computerguy096/Eagle-8/kicad/bom/eagle-8.csv

Reference | Value | Datasheet | Footprint | Qty | DNP | LCSC
C1,C2,C3,C4,C5,C6,C7,C8,C9,C10,C11,C12,C13,C14,C15,C16,C17,C18,C19,C20,C21,C22,C23,C24,C25,C26,C27,C28,C29,C38 | 100nF |  | Capacitor_SMD:C_0805_2012Metric | 30 |  | C1711
C30,C31,C32,C33,C34,C35,C36,C37 | 47uF |  | Capacitor_Tantalum_SMD:CP_EIA-7343-40_Kemet-Y_HandSolder | 8 |  | C600546
R1,R2,R3 | 150R |  | Resistor_SMD:R_0805_2012Metric | 3 |  | C17471
R4,R5,R6 | 10K |  | Resistor_SMD:R_0805_2012Metric | 3 |  | C17414
R7 | 0R |  | Resistor_SMD:R_0805_2012Metric | 1 |  | C17477
R14 | 68R |  | Resistor_SMD:R_0805_2012Metric | 1 |  | C17802
RN1,RN2,RN3,RN4,RN5,RN6,RN7,RN8,RN9,RN10,RN11,RN12,RN13,RN14,RN15,RN16,RN17,RN18,RN19,RN20,RN21,RN22,RN23,RN24,RN25,RN26,RN27,RN28,RN29,RN30,RN31,RN32,RN33,RN34,RN35 | 68R |  | eagle-8:VTT array | 35 |  | C429297
