computerguy096/Eagle-8/spacer.stl

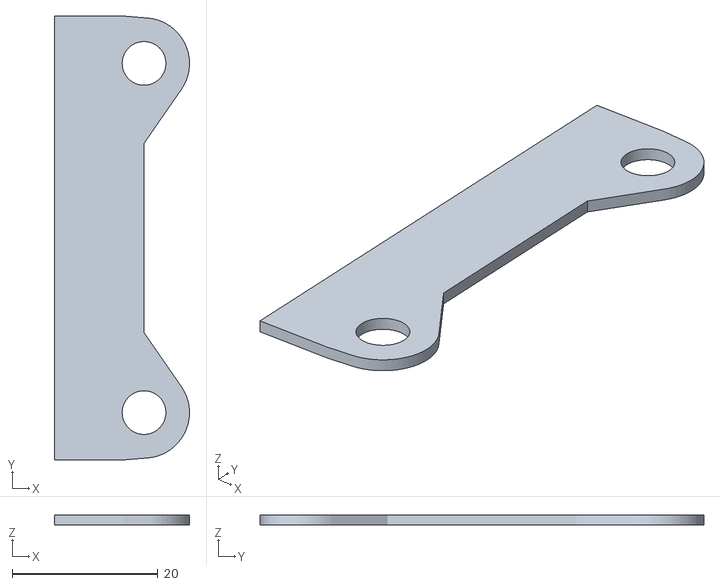
[picture p2: CAD file, 2026-10-31]
spacer.stl
18.5 x 61.0 x 1.40
