computerguy096/Eagle-8/kicad/eagle-8.kicad_pcb

## KiCad design kicad/eagle-8.kicad_pcb (2026-11-05)

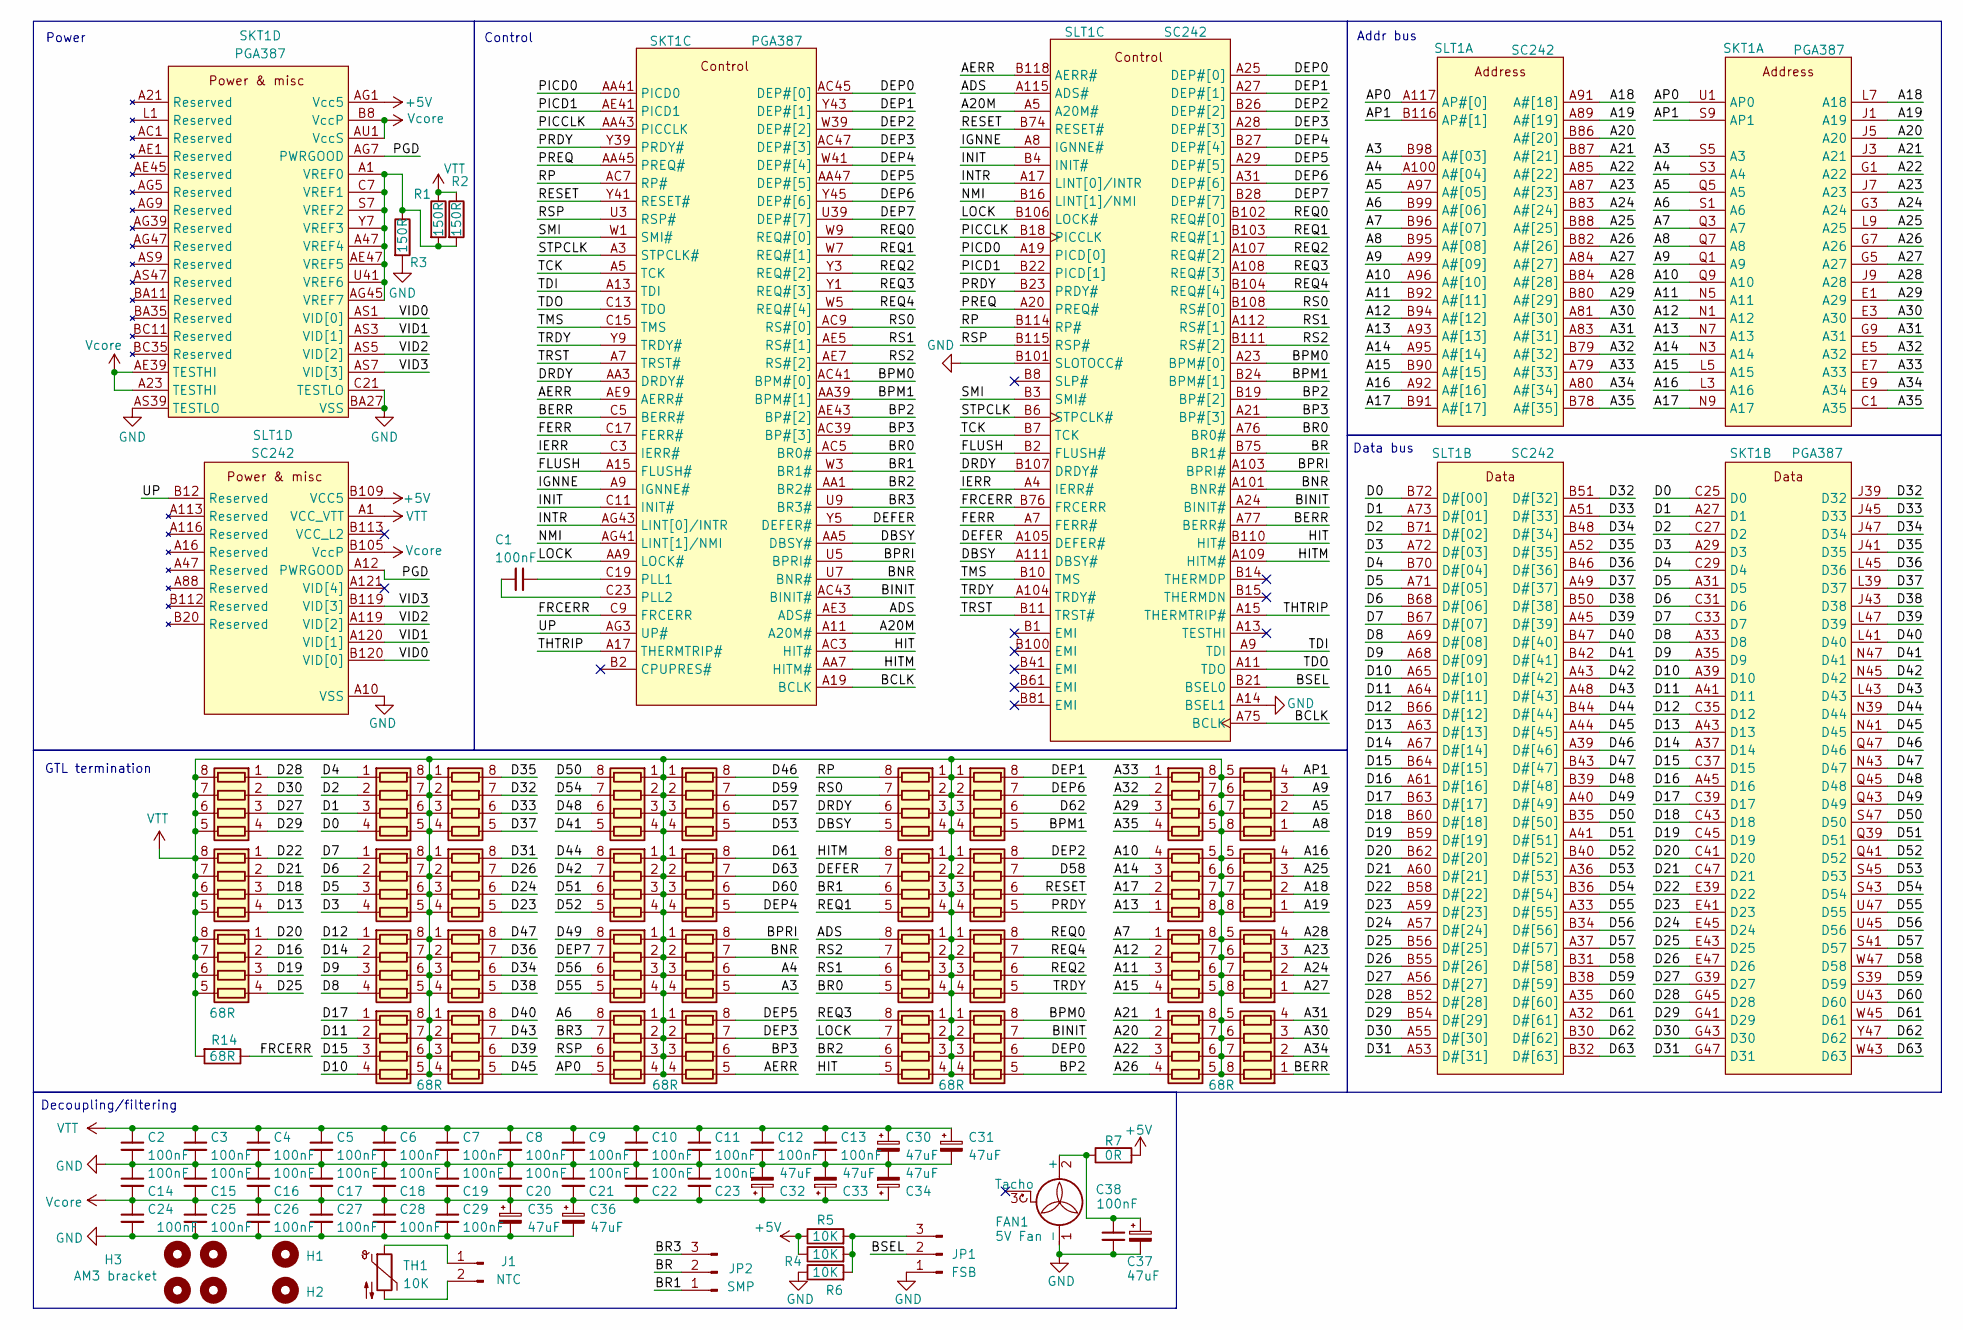
[picture p3: schematic eagle-8.kicad_sch]

Parts:
C1, C2: 100nF; C_0805_2012Metric; LCSC C1711
C3, C4, C5, C6, C7, C8, C9, C10, C11, C12, C13, C14, C15, C16, C17, C18, C19, C20, C21, C22, C23, C24, C25, C26, C27, C28, C29, C38: 100nF; C_0805_2012Metric
C30, C31, C32, C33, C34, C35, C37: 47uF; CP_EIA-7343-40_Kemet-Y_HandSolder
C36: 47uF; CP_EIA-7343-40_Kemet-Y_HandSolder; LCSC C600546
FAN1: 5V Fan; FanPinHeader_1x03_P2.54mm_Vertical
H1, H2: MountingHole; MountingHole_3.2mm_M3_DIN965
H3: AM3 bracket
J1: NTC; PinHeader_1x02_P2.54mm_Vertical
JP1: FSB; PinHeader_1x03_P2.54mm_Vertical
JP2: SMP; PinHeader_1x03_P2.54mm_Vertical
R1, R2, R3: 150R; R_0805_2012Metric; LCSC C17471
R4, R5, R6: 10K; R_0805_2012Metric; LCSC C17414
R7: 0R; R_0805_2012Metric; LCSC C17477
R14: 68R; R_0805_2012Metric; LCSC C17802
RN1, RN2, RN3, RN4, RN5, RN6, RN7, RN8, RN9, RN10, RN11, RN13, RN14, RN15, RN16, RN17, RN18, RN19, RN20, RN21, RN22, RN23, RN24, RN25, RN26, RN27, RN28, RN29, RN30, RN31, RN32, RN33, RN34, RN35: 68R; VTT array
RN12: 68R; VTT array; LCSC C429297
SKT1: PGA387
SLT1: SC242; Slot 1
TH1: 10K; PinHeader_1x02_P2.54mm_Vertical

Connections:
+5V: R4.1, R5.1, R7.2, SKT1.AG1 (Vcc5), SLT1.B109 (VCC5)
/A3: RN31.5 (R4.2), SKT1.S5 (A3), SLT1.B98 (A#[03])
/A4: RN31.6 (R3.2), SKT1.S3 (A4), SLT1.A100 (A#[04])
/A5: RN1.2 (R2.1), SKT1.Q5 (A5), SLT1.A97 (A#[05])
/A6: RN35.8 (R1.2), SKT1.S1 (A6), SLT1.B99 (A#[06])
/A7: RN4.1 (R1.1), SKT1.Q3 (A7), SLT1.B96 (A#[07])
/A8: RN1.1 (R1.1), SKT1.Q7 (A8), SLT1.B95 (A#[08])
/A9: RN1.3 (R3.1), SKT1.Q1 (A9), SLT1.A99 (A#[09])
/A10: RN2.4 (R4.1), SKT1.Q9 (A10), SLT1.A96 (A#[10])
/A11: RN4.3 (R3.1), SKT1.N5 (A11), SLT1.B92 (A#[11])
/A12: RN4.2 (R2.1), SKT1.N1 (A12), SLT1.B94 (A#[12])
/A13: RN2.1 (R1.1), SKT1.N7 (A13), SLT1.A93 (A#[13])
/A14: RN2.3 (R3.1), SKT1.N3 (A14), SLT1.A95 (A#[14])
/A15: RN4.4 (R4.1), SKT1.L5 (A15), SLT1.B90 (A#[15])
/A16: RN3.4 (R4.1), SKT1.L3 (A16), SLT1.A92 (A#[16])
/A17: RN2.2 (R2.1), SKT1.N9 (A17), SLT1.B91 (A#[17])
/A18: RN3.2 (R2.1), SKT1.L7 (A18), SLT1.A91 (A#[18])
/A19: RN3.1 (R1.1), SKT1.J1 (A19), SLT1.A89 (A#[19])
/A20: RN6.2 (R2.1), SKT1.J5 (A20), SLT1.B86 (A#[20])
/A20M: SKT1.A11 (A20M#), SLT1.A5 (A20M#)
/A21: RN6.1 (R1.1), SKT1.J3 (A21), SLT1.B87 (A#[21])
/A22: RN6.3 (R3.1), SKT1.G1 (A22), SLT1.A85 (A#[22])
/A23: RN5.3 (R3.1), SKT1.J7 (A23), SLT1.A87 (A#[23])
/A24: RN5.2 (R2.1), SKT1.G3 (A24), SLT1.B83 (A#[24])
/A25: RN3.3 (R3.1), SKT1.L9 (A25), SLT1.B88 (A#[25])
/A26: RN6.4 (R4.1), SKT1.G7 (A26), SLT1.B82 (A#[26])
/A27: RN5.1 (R1.1), SKT1.G5 (A27), SLT1.A84 (A#[27])
/A28: RN5.4 (R4.1), SKT1.J9 (A28), SLT1.B84 (A#[28])
/A29: RN24.3 (R3.1), SKT1.E1 (A29), SLT1.B80 (A#[29])
/A30: RN7.3 (R3.1), SKT1.E3 (A30), SLT1.A81 (A#[30])
/A31: RN7.4 (R4.1), SKT1.G9 (A31), SLT1.A83 (A#[31])
/A32: RN24.2 (R2.1), SKT1.E5 (A32), SLT1.B79 (A#[32])
/A33: RN24.1 (R1.1), SKT1.E7 (A33), SLT1.A79 (A#[33])
/A34: RN7.2 (R2.1), SKT1.E9 (A34), SLT1.A80 (A#[34])
/A35: RN24.4 (R4.1), SKT1.C1 (A35), SLT1.B78 (A#[35])
/ADS: RN29.8 (R1.2), SKT1.AE3 (ADS#), SLT1.A115 (ADS#)
/AERR: RN32.5 (R4.2), SKT1.AE9 (AERR#), SLT1.B118 (AERR#)
/AP0: RN35.5 (R4.2), SKT1.U1 (AP0), SLT1.A117 (AP#[0])
/AP1: RN1.4 (R4.1), SKT1.S9 (AP1), SLT1.B116 (AP#[1])
/BCLK: SKT1.A19 (BCLK), SLT1.A75 (BCLK)
/BERR: RN7.1 (R1.1), SKT1.C5 (BERR#), SLT1.A77 (BERR#)
/BINIT: RN28.7 (R2.2), SKT1.AC43 (BINIT#), SLT1.A24 (BINIT#)
/BNR: RN31.7 (R2.2), SKT1.U7 (BNR#), SLT1.A101 (BNR#)
/BP2: RN28.5 (R4.2), SKT1.AE43 (BP#[2]), SLT1.B19 (BP#[2])
/BP3: RN32.6 (R3.2), SKT1.AC39 (BP#[3]), SLT1.A21 (BP#[3])
/BPM0: RN28.8 (R1.2), SKT1.AC41 (BPM#[0]), SLT1.A23 (BPM#[0])
/BPM1: RN25.5 (R4.2), SKT1.AA39 (BPM#[1]), SLT1.B24 (BPM#[1])
/BPRI: RN31.8 (R1.2), SKT1.U5 (BPRI#), SLT1.A103 (BPRI#)
/BR: JP2.2, SLT1.B75 (BR1#)
/BR0: RN29.5 (R4.2), SKT1.AC5 (BR0#), SLT1.A76 (BR0#)
/BR1: JP2.1, RN34.6 (R3.2), SKT1.W3 (BR1#)
/BR2: RN30.6 (R3.2), SKT1.AA1 (BR2#)
/BR3: JP2.3, RN35.7 (R2.2), SKT1.U9 (BR3#)
/BSEL: JP1.2, SLT1.B21 (BSEL0)
/D0: RN8.4 (R4.1), SKT1.C25 (D0), SLT1.B72 (D#[00])
/D1: RN8.3 (R3.1), SKT1.A27 (D1), SLT1.A73 (D#[01])
/D2: RN8.2 (R2.1), SKT1.C27 (D2), SLT1.B71 (D#[02])
/D3: RN9.4 (R4.1), SKT1.A29 (D3), SLT1.A72 (D#[03])
/D4: RN8.1 (R1.1), SKT1.C29 (D4), SLT1.B70 (D#[04])
/D5: RN9.3 (R3.1), SKT1.A31 (D5), SLT1.A71 (D#[05])
/D6: RN9.2 (R2.1), SKT1.C31 (D6), SLT1.B68 (D#[06])
/D7: RN9.1 (R1.1), SKT1.C33 (D7), SLT1.B67 (D#[07])
/D8: RN10.4 (R4.1), SKT1.A33 (D8), SLT1.A69 (D#[08])
/D9: RN10.3 (R3.1), SKT1.A35 (D9), SLT1.A68 (D#[09])
/D10: RN11.4 (R4.1), SKT1.A39 (D10), SLT1.A65 (D#[10])
/D11: RN11.2 (R2.1), SKT1.A41 (D11), SLT1.A64 (D#[11])
/D12: RN10.1 (R1.1), SKT1.C35 (D12), SLT1.B66 (D#[12])
/D13: RN13.4 (R4.1), SKT1.A43 (D13), SLT1.A63 (D#[13])
/D14: RN10.2 (R2.1), SKT1.A37 (D14), SLT1.A67 (D#[14])
/D15: RN11.3 (R3.1), SKT1.C37 (D15), SLT1.B64 (D#[15])
/D16: RN14.2 (R2.1), SKT1.A45 (D16), SLT1.A61 (D#[16])
/D17: RN11.1 (R1.1), SKT1.C39 (D17), SLT1.B63 (D#[17])
/D18: RN13.3 (R3.1), SKT1.C43 (D18), SLT1.B60 (D#[18])
/D19: RN14.3 (R3.1), SKT1.C45 (D19), SLT1.B59 (D#[19])
/D20: RN14.1 (R1.1), SKT1.C41 (D20), SLT1.B62 (D#[20])
/D21: RN13.2 (R2.1), SKT1.C47 (D21), SLT1.A60 (D#[21])
/D22: RN13.1 (R1.1), SKT1.E39 (D22), SLT1.B58 (D#[22])
/D23: RN16.5 (R4.2), SKT1.E41 (D23), SLT1.A59 (D#[23])
/D24: RN16.6 (R3.2), SKT1.E45 (D24), SLT1.A57 (D#[24])
/D25: RN14.4 (R4.1), SKT1.E43 (D25), SLT1.B56 (D#[25])
/D26: RN16.7 (R2.2), SKT1.E47 (D26), SLT1.B55 (D#[26])
/D27: RN12.3 (R3.1), SKT1.G39 (D27), SLT1.A56 (D#[27])
/D28: RN12.1 (R1.1), SKT1.G45 (D28), SLT1.B52 (D#[28])
/D29: RN12.4 (R4.1), SKT1.G41 (D29), SLT1.B54 (D#[29])
/D30: RN12.2 (R2.1), SKT1.G43 (D30), SLT1.A55 (D#[30])
/D31: RN16.8 (R1.2), SKT1.G47 (D31), SLT1.A53 (D#[31])
/D32: RN15.7 (R2.2), SKT1.J39 (D32), SLT1.B51 (D#[32])
/D33: RN15.6 (R3.2), SKT1.J45 (D33), SLT1.A51 (D#[33])
/D34: RN17.6 (R3.2), SKT1.J47 (D34), SLT1.B48 (D#[34])
/D35: RN15.8 (R1.2), SKT1.J41 (D35), SLT1.A52 (D#[35])
/D36: RN17.7 (R2.2), SKT1.L45 (D36), SLT1.B46 (D#[36])
/D37: RN15.5 (R4.2), SKT1.L39 (D37), SLT1.A49 (D#[37])
/D38: RN17.5 (R4.2), SKT1.J43 (D38), SLT1.B50 (D#[38])
/D39: RN18.6 (R3.2), SKT1.L47 (D39), SLT1.A45 (D#[39])
/D40: RN18.8 (R1.2), SKT1.L41 (D40), SLT1.B47 (D#[40])
/D41: RN19.5 (R4.2), SKT1.N47 (D41), SLT1.B42 (D#[41])
/D42: RN20.7 (R2.2), SKT1.N45 (D42), SLT1.A43 (D#[42])
/D43: RN18.7 (R2.2), SKT1.L43 (D43), SLT1.A48 (D#[43])
/D44: RN20.8 (R1.2), SKT1.N39 (D44), SLT1.B44 (D#[44])
/D45: RN18.5 (R4.2), SKT1.N41 (D45), SLT1.A44 (D#[45])
/D46: RN22.8 (R1.2), SKT1.Q47 (D46), SLT1.A39 (D#[46])
/D47: RN17.8 (R1.2), SKT1.N43 (D47), SLT1.B43 (D#[47])
/D48: RN19.6 (R3.2), SKT1.Q45 (D48), SLT1.B39 (D#[48])
/D49: RN21.8 (R1.2), SKT1.Q43 (D49), SLT1.A40 (D#[49])
/D50: RN19.8 (R1.2), SKT1.S47 (D50), SLT1.B35 (D#[50])
/D51: RN20.6 (R3.2), SKT1.Q39 (D51), SLT1.A41 (D#[51])
/D52: RN20.5 (R4.2), SKT1.Q41 (D52), SLT1.B40 (D#[52])
/D53: RN22.5 (R4.2), SKT1.S45 (D53), SLT1.A36 (D#[53])
/D54: RN19.7 (R2.2), SKT1.S43 (D54), SLT1.B36 (D#[54])
/D55: RN21.5 (R4.2), SKT1.U47 (D55), SLT1.A33 (D#[55])
/D56: RN21.6 (R3.2), SKT1.U45 (D56), SLT1.B34 (D#[56])
/D57: RN22.6 (R3.2), SKT1.S41 (D57), SLT1.A37 (D#[57])
/D58: RN26.7 (R2.2), SKT1.W47 (D58), SLT1.B31 (D#[58])
/D59: RN22.7 (R2.2), SKT1.S39 (D59), SLT1.B38 (D#[59])
/D60: RN23.6 (R3.2), SKT1.U43 (D60), SLT1.A35 (D#[60])
/D61: RN23.8 (R1.2), SKT1.W45 (D61), SLT1.A32 (D#[61])
/D62: RN25.6 (R3.2), SKT1.Y47 (D62), SLT1.B30 (D#[62])
/D63: RN23.7 (R2.2), SKT1.W43 (D63), SLT1.B32 (D#[63])
/DBSY: RN33.5 (R4.2), SKT1.AA5 (DBSY#), SLT1.A111 (DBSY#)
/DEFER: RN34.7 (R2.2), SKT1.Y5 (DEFER#), SLT1.A105 (DEFER#)
/DEP0: RN28.6 (R3.2), SKT1.AC45 (DEP#[0]), SLT1.A25 (DEP#[0])
/DEP1: RN25.8 (R1.2), SKT1.Y43 (DEP#[1]), SLT1.A27 (DEP#[1])
/DEP2: RN26.8 (R1.2), SKT1.W39 (DEP#[2]), SLT1.B26 (DEP#[2])
/DEP3: RN32.7 (R2.2), SKT1.AC47 (DEP#[3]), SLT1.A28 (DEP#[3])
/DEP4: RN23.5 (R4.2), SKT1.W41 (DEP#[4]), SLT1.B27 (DEP#[4])
/DEP5: RN32.8 (R1.2), SKT1.AA47 (DEP#[5]), SLT1.A29 (DEP#[5])
/DEP6: RN25.7 (R2.2), SKT1.Y45 (DEP#[6]), SLT1.A31 (DEP#[6])
/DEP7: RN21.7 (R2.2), SKT1.U39 (DEP#[7]), SLT1.B28 (DEP#[7])
/DRDY: RN33.6 (R3.2), SKT1.AA3 (DRDY#), SLT1.B107 (DRDY#)
/FERR: SKT1.C17 (FERR#), SLT1.A7 (FERR#)
/FLUSH: SKT1.A15 (FLUSH#), SLT1.B2 (FLUSH#)
/FRCERR: R14.1, SKT1.C9 (FRCERR), SLT1.B76 (FRCERR)
/HIT: RN30.5 (R4.2), SKT1.AC3 (HIT#), SLT1.B110 (HIT#)
/HITM: RN34.8 (R1.2), SKT1.AA7 (HITM#), SLT1.A109 (HITM#)
/IERR: SKT1.C3 (IERR#), SLT1.A4 (IERR#)
/IGNNE: SKT1.A9 (IGNNE#), SLT1.A8 (IGNNE#)
/INIT: SKT1.C11 (INIT#), SLT1.B4 (INIT#)
/INTR: SKT1.AG43 (LINT[0]/INTR), SLT1.A17 (LINT[0]/INTR)
/LOCK: RN30.7 (R2.2), SKT1.AA9 (LOCK#), SLT1.B106 (LOCK#)
/NMI: SKT1.AG41 (LINT[1]/NMI), SLT1.B16 (LINT[1]/NMI)
/PGD: SKT1.AG7 (PWRGOOD), SLT1.A12 (PWRGOOD)
/PICCLK: SKT1.AA43 (PICCLK), SLT1.B18 (PICCLK)
/PICD0: SKT1.AA41 (PICD0), SLT1.A19 (PICD[0])
/PICD1: SKT1.AE41 (PICD1), SLT1.B22 (PICD[1])
/PRDY: RN26.5 (R4.2), SKT1.Y39 (PRDY#), SLT1.B23 (PRDY#)
/PREQ: SKT1.AA45 (PREQ#), SLT1.A20 (PREQ#)
/REQ0: RN27.8 (R1.2), SKT1.W9 (REQ#[0]), SLT1.B102 (REQ#[0])
/REQ1: RN34.5 (R4.2), SKT1.W7 (REQ#[1]), SLT1.B103 (REQ#[1])
/REQ2: RN27.6 (R3.2), SKT1.Y3 (REQ#[2]), SLT1.A107 (REQ#[2])
/REQ3: RN30.8 (R1.2), SKT1.Y1 (REQ#[3]), SLT1.A108 (REQ#[3])
/REQ4: RN27.7 (R2.2), SKT1.W5 (REQ#[4]), SLT1.B104 (REQ#[4])
/RESET: RN26.6 (R3.2), SKT1.Y41 (RESET#), SLT1.B74 (RESET#)
/RP: RN33.8 (R1.2), SKT1.AC7 (RP#), SLT1.B114 (RP#)
/RS0: RN33.7 (R2.2), SKT1.AC9 (RS#[0]), SLT1.B108 (RS#[0])
/RS1: RN29.6 (R3.2), SKT1.AE5 (RS#[1]), SLT1.A112 (RS#[1])
/RS2: RN29.7 (R2.2), SKT1.AE7 (RS#[2]), SLT1.B111 (RS#[2])
/RSP: RN35.6 (R3.2), SKT1.U3 (RSP#), SLT1.B115 (RSP#)
/SMI: SKT1.W1 (SMI#), SLT1.B3 (SMI#)
/STPCLK: SKT1.A3 (STPCLK#), SLT1.B6 (STPCLK#)
/TCK: SKT1.A5 (TCK), SLT1.B7 (TCK)
/TDI: SKT1.A13 (TDI), SLT1.A9 (TDI)
/TDO: SKT1.C13 (TDO), SLT1.A11 (TDO)
/THTRIP: SKT1.A17 (THERMTRIP#), SLT1.A15 (THERMTRIP#)
/TMS: SKT1.C15 (TMS), SLT1.B10 (TMS)
/TRDY: RN27.5 (R4.2), SKT1.Y9 (TRDY#), SLT1.A104 (TRDY#)
/TRST: SKT1.A7 (TRST#), SLT1.B11 (TRST#)
/UP: SKT1.AG3 (UP#), SLT1.B12 (Reserved)
/VID0: SKT1.AS1 (VID[0]), SLT1.B120 (VID[0])
/VID1: SKT1.AS3 (VID[1]), SLT1.A120 (VID[1])
/VID2: SKT1.AS5 (VID[2]), SLT1.A119 (VID[2])
/VID3: SKT1.AS7 (VID[3]), SLT1.B119 (VID[3])
GND: C2.1, C3.1, C4.1, C5.1, C6.1, C7.1, C8.1, C9.1, C10.1, C11.1, C12.1, C13.1, C14.1, C15.1, C16.1, C17.1, C18.1, C19.1, C20.1, C21.1, C22.1, C23.1, C24.1, C25.1, C26.1, C27.1, C28.1, C29.1, C30.2, C31.2, C32.2, C33.2, C34.2, C35.2, C36.2, C37.2, C38.1, FAN1.1 (-), JP1.1, R3.2, R6.1, SKT1.AB2 (VSS), SKT1.AB6 (VSS), SKT1.AB8 (VSS), SKT1.AB40 (VSS), SKT1.AB42 (VSS), SKT1.AB46 (VSS), SKT1.AF2 (VSS), SKT1.AF4 (VSS), SKT1.AF6 (VSS), SKT1.AF8 (VSS), SKT1.AF40 (VSS), SKT1.AF42 (VSS), SKT1.AF44 (VSS), SKT1.AF46 (VSS), SKT1.AJ1 (VSS), SKT1.AJ5 (VSS), SKT1.AJ9 (VSS), SKT1.AJ39 (VSS), SKT1.AJ43 (VSS), SKT1.AJ47 (VSS), SKT1.AL3 (VSS), SKT1.AL7 (VSS), SKT1.AL41 (VSS), SKT1.AL45 (VSS), SKT1.AN1 (VSS), SKT1.AN5 (VSS), SKT1.AN9 (VSS), SKT1.AN39 (VSS), SKT1.AN43 (VSS), SKT1.AN47 (VSS), SKT1.AQ3 (VSS), SKT1.AQ7 (VSS), SKT1.AQ41 (VSS), SKT1.AQ45 (VSS), SKT1.AS39 (TESTLO), SKT1.AS41 (TESTLO), SKT1.AS43 (TESTLO), SKT1.AS45 (TESTLO), SKT1.AU3 (VSS), SKT1.AU7 (VSS), SKT1.AU41 (VSS), SKT1.AU45 (VSS), SKT1.AW1 (VSS), SKT1.AW5 (VSS), SKT1.AW9 (VSS), SKT1.AW39 (VSS), SKT1.AW43 (VSS), SKT1.AW47 (VSS), SKT1.B6 (VSS), SKT1.B12 (VSS), SKT1.B20 (VSS), SKT1.B28 (VSS), SKT1.B36 (VSS), SKT1.B42 (VSS), SKT1.B46 (VSS), SKT1.BA1 (VSS), SKT1.BA5 (VSS), SKT1.BA9 (VSS), SKT1.BA13 (TESTLO), SKT1.BA15 (TESTLO), SKT1.BA19 (VSS), SKT1.BA23 (VSS), SKT1.BA27 (VSS), SKT1.BA31 (VSS), SKT1.BA33 (TESTLO), SKT1.BA37 (TESTLO), SKT1.BA39 (VSS), SKT1.BA43 (VSS), SKT1.BA47 (VSS), SKT1.BC1 (VSS), SKT1.BC3 (VSS), SKT1.BC5 (VSS), SKT1.BC7 (VSS), SKT1.BC9 (VSS), SKT1.BC13 (TESTLO), SKT1.BC15 (TESTLO), SKT1.BC17 (VSS), SKT1.BC21 (VSS), SKT1.BC25 (VSS), SKT1.BC29 (VSS), SKT1.BC33 (TESTLO), SKT1.BC37 (TESTLO), SKT1.BC39 (VSS), SKT1.BC41 (VSS), SKT1.BC43 (VSS), SKT1.BC45 (VSS), SKT1.BC47 (VSS), SKT1.C21 (TESTLO), SKT1.F4 (VSS), SKT1.F8 (VSS), SKT1.F40 (VSS), SKT1.F44 (VSS), SKT1.K2 (VSS), SKT1.K6 (VSS), SKT1.K8 (VSS), SKT1.K40 (VSS), SKT1.K42 (VSS), SKT1.K46 (VSS), SKT1.P4 (VSS), SKT1.P8 (VSS), SKT1.P40 (VSS), SKT1.P44 (VSS), SKT1.T2 (VSS), SKT1.T6 (VSS), SKT1.T8 (VSS), SKT1.T40 (VSS), SKT1.T42 (VSS), SKT1.T46 (VSS), SKT1.X2 (VSS), SKT1.X4 (VSS), SKT1.X8 (VSS), SKT1.X40 (VSS), SKT1.X44 (VSS), SKT1.X46 (VSS), SLT1.A2 (VSS), SLT1.A6 (VSS), SLT1.A10 (VSS), SLT1.A14 (BSEL1), SLT1.A18 (VSS), SLT1.A22 (VSS), SLT1.A26 (VSS), SLT1.A30 (VSS), SLT1.A34 (VSS), SLT1.A38 (VSS), SLT1.A42 (VSS), SLT1.A46 (VSS), SLT1.A50 (VSS), SLT1.A54 (VSS), SLT1.A58 (VSS), SLT1.A62 (VSS), SLT1.A66 (VSS), SLT1.A70 (VSS), SLT1.A74 (VSS), SLT1.A78 (VSS), SLT1.A82 (VSS), SLT1.A86 (VSS), SLT1.A90 (VSS), SLT1.A94 (VSS), SLT1.A98 (VSS), SLT1.A102 (VSS), SLT1.A106 (VSS), SLT1.A110 (VSS), SLT1.A114 (VSS), SLT1.A118 (VSS), SLT1.B101 (SLOTOCC#)
unnamed: C37.1, C38.2, FAN1.2 (+), R7.1
unnamed: J1.1, TH1.1
unnamed: J1.2, TH1.2
unnamed: JP1.3, R4.2, R5.2, R6.2
unnamed: C1.2, SKT1.C19 (PLL1)
unnamed: C1.1, SKT1.C23 (PLL2)
unnamed: R1.2, R2.2, R3.1, SKT1.A1 (VREF0), SKT1.A47 (VREF4), SKT1.AE47 (VREF5), SKT1.AG45 (VREF7), SKT1.C7 (VREF1), SKT1.S7 (VREF2), SKT1.U41 (VREF6), SKT1.Y7 (VREF3)
VTT: C2.2, C3.2, C4.2, C5.2, C6.2, C7.2, C8.2, C9.2, C10.2, C11.2, C12.2, C13.2, C30.1, C31.1, R1.1, R2.1, R14.2, RN1.5 (R4.2), RN1.6 (R3.2), RN1.7 (R2.2), RN1.8 (R1.2), RN2.5 (R4.2), RN2.6 (R3.2), RN2.7 (R2.2), RN2.8 (R1.2), RN3.5 (R4.2), RN3.6 (R3.2), RN3.7 (R2.2), RN3.8 (R1.2), RN4.5 (R4.2), RN4.6 (R3.2), RN4.7 (R2.2), RN4.8 (R1.2), RN5.5 (R4.2), RN5.6 (R3.2), RN5.7 (R2.2), RN5.8 (R1.2), RN6.5 (R4.2), RN6.6 (R3.2), RN6.7 (R2.2), RN6.8 (R1.2), RN7.5 (R4.2), RN7.6 (R3.2), RN7.7 (R2.2), RN7.8 (R1.2), RN8.5 (R4.2), RN8.6 (R3.2), RN8.7 (R2.2), RN8.8 (R1.2), RN9.5 (R4.2), RN9.6 (R3.2), RN9.7 (R2.2), RN9.8 (R1.2), RN10.5 (R4.2), RN10.6 (R3.2), RN10.7 (R2.2), RN10.8 (R1.2), RN11.5 (R4.2), RN11.6 (R3.2), RN11.7 (R2.2), RN11.8 (R1.2), RN12.5 (R4.2), RN12.6 (R3.2), RN12.7 (R2.2), RN12.8 (R1.2), RN13.5 (R4.2), RN13.6 (R3.2), RN13.7 (R2.2), RN13.8 (R1.2), RN14.5 (R4.2), RN14.6 (R3.2), RN14.7 (R2.2), RN14.8 (R1.2), RN15.1 (R1.1), RN15.2 (R2.1), RN15.3 (R3.1), RN15.4 (R4.1), RN16.1 (R1.1), RN16.2 (R2.1), RN16.3 (R3.1), RN16.4 (R4.1), RN17.1 (R1.1), RN17.2 (R2.1), RN17.3 (R3.1), RN17.4 (R4.1), RN18.1 (R1.1), RN18.2 (R2.1), RN18.3 (R3.1), RN18.4 (R4.1), RN19.1 (R1.1), RN19.2 (R2.1), RN19.3 (R3.1), RN19.4 (R4.1), RN20.1 (R1.1), RN20.2 (R2.1), RN20.3 (R3.1), RN20.4 (R4.1), RN21.1 (R1.1), RN21.2 (R2.1), RN21.3 (R3.1), RN21.4 (R4.1), RN22.1 (R1.1), RN22.2 (R2.1), RN22.3 (R3.1), RN22.4 (R4.1), RN23.1 (R1.1), RN23.2 (R2.1), RN23.3 (R3.1), RN23.4 (R4.1), RN24.5 (R4.2), RN24.6 (R3.2), RN24.7 (R2.2), RN24.8 (R1.2), RN25.1 (R1.1), RN25.2 (R2.1), RN25.3 (R3.1), RN25.4 (R4.1), RN26.1 (R1.1), RN26.2 (R2.1), RN26.3 (R3.1), RN26.4 (R4.1), RN27.1 (R1.1), RN27.2 (R2.1), RN27.3 (R3.1), RN27.4 (R4.1), RN28.1 (R1.1), RN28.2 (R2.1), RN28.3 (R3.1), RN28.4 (R4.1), RN29.1 (R1.1), RN29.2 (R2.1), RN29.3 (R3.1), RN29.4 (R4.1), RN30.1 (R1.1), RN30.2 (R2.1), RN30.3 (R3.1), RN30.4 (R4.1), RN31.1 (R1.1), RN31.2 (R2.1), RN31.3 (R3.1), RN31.4 (R4.1), RN32.1 (R1.1), RN32.2 (R2.1), RN32.3 (R3.1), RN32.4 (R4.1), RN33.1 (R1.1), RN33.2 (R2.1), RN33.3 (R3.1), RN33.4 (R4.1), RN34.1 (R1.1), RN34.2 (R2.1), RN34.3 (R3.1), RN34.4 (R4.1), RN35.1 (R1.1), RN35.2 (R2.1), RN35.3 (R3.1), RN35.4 (R4.1), SLT1.A1 (VCC_VTT), SLT1.A3 (VCC_VTT), SLT1.B5 (VCC_VTT), SLT1.B9 (VCC_VTT)
Vcore: C14.2, C15.2, C16.2, C17.2, C18.2, C19.2, C20.2, C21.2, C22.2, C23.2, C24.2, C25.2, C26.2, C27.2, C28.2, C29.2, C32.1, C33.1, C34.1, C35.1, C36.1, SKT1.A23 (TESTHI), SKT1.A25 (TESTHI), SKT1.AB4 (VccP), SKT1.AB44 (VccP), SKT1.AE39 (TESTHI), SKT1.AJ3 (VccP), SKT1.AJ7 (VccP), SKT1.AJ41 (VccP), SKT1.AJ45 (VccP), SKT1.AL1 (VccP), SKT1.AL5 (VccP), SKT1.AL9 (VccP), SKT1.AL39 (VccP), SKT1.AL43 (VccP), SKT1.AL47 (VccP), SKT1.AN3 (VccP), SKT1.AN7 (VccP), SKT1.AN41 (VccP), SKT1.AN45 (VccP), SKT1.AQ1 (VccP), SKT1.AQ5 (VccP), SKT1.AQ9 (VccP), SKT1.AQ39 (VccP), SKT1.AQ43 (VccP), SKT1.AQ47 (VccP), SKT1.AU1 (VccS), SKT1.AU5 (VccS), SKT1.AU9 (VccS), SKT1.AU39 (VccS), SKT1.AU43 (VccS), SKT1.AU47 (VccS), SKT1.AW3 (VccS), SKT1.AW7 (VccS), SKT1.AW41 (VccS), SKT1.AW45 (VccS), SKT1.AY1 (VccS), SKT1.AY3 (VccS), SKT1.AY5 (VccS), SKT1.AY7 (VccS), SKT1.AY9 (VccS), SKT1.AY39 (VccS), SKT1.AY41 (VccS), SKT1.AY43 (VccS), SKT1.AY45 (VccS), SKT1.AY47 (VccS), SKT1.B4 (VccP), SKT1.B8 (VccP), SKT1.B16 (VccP), SKT1.B24 (VccP), SKT1.B32 (VccP), SKT1.B40 (VccP), SKT1.B44 (VccP), SKT1.BA3 (VccS), SKT1.BA7 (VccS), SKT1.BA17 (VccP), SKT1.BA21 (VccP), SKT1.BA25 (VccP), SKT1.BA29 (VccP), SKT1.BA41 (VccS), SKT1.BA45 (VccS), SKT1.BC19 (VccS), SKT1.BC23 (VccS), SKT1.BC27 (VccS), SKT1.BC31 (VccS), SKT1.F2 (VccP), SKT1.F6 (VccP), SKT1.F42 (VccP), SKT1.F46 (VccP), SKT1.K4 (VccP), SKT1.K44 (VccP), SKT1.P2 (VccP), SKT1.P6 (VccP), SKT1.P42 (VccP), SKT1.P46 (VccP), SKT1.T4 (VccP), SKT1.T44 (VccP), SKT1.X6 (VccP), SKT1.X42 (VccP), SLT1.B13 (VccP), SLT1.B17 (VccP), SLT1.B25 (VccP), SLT1.B29 (VccP), SLT1.B33 (VccP), SLT1.B37 (VccP), SLT1.B45 (VccP), SLT1.B49 (VccP), SLT1.B53 (VccP), SLT1.B57 (VccP), SLT1.B65 (VccP), SLT1.B69 (VccP), SLT1.B73 (VccP), SLT1.B77 (VccP), SLT1.B85 (VccP), SLT1.B89 (VccP), SLT1.B93 (VccP), SLT1.B97 (VccP), SLT1.B105 (VccP)

Notes on the sheet:
Control
GTL termination
Data bus
Decoupling/filtering
Power
Addr bus

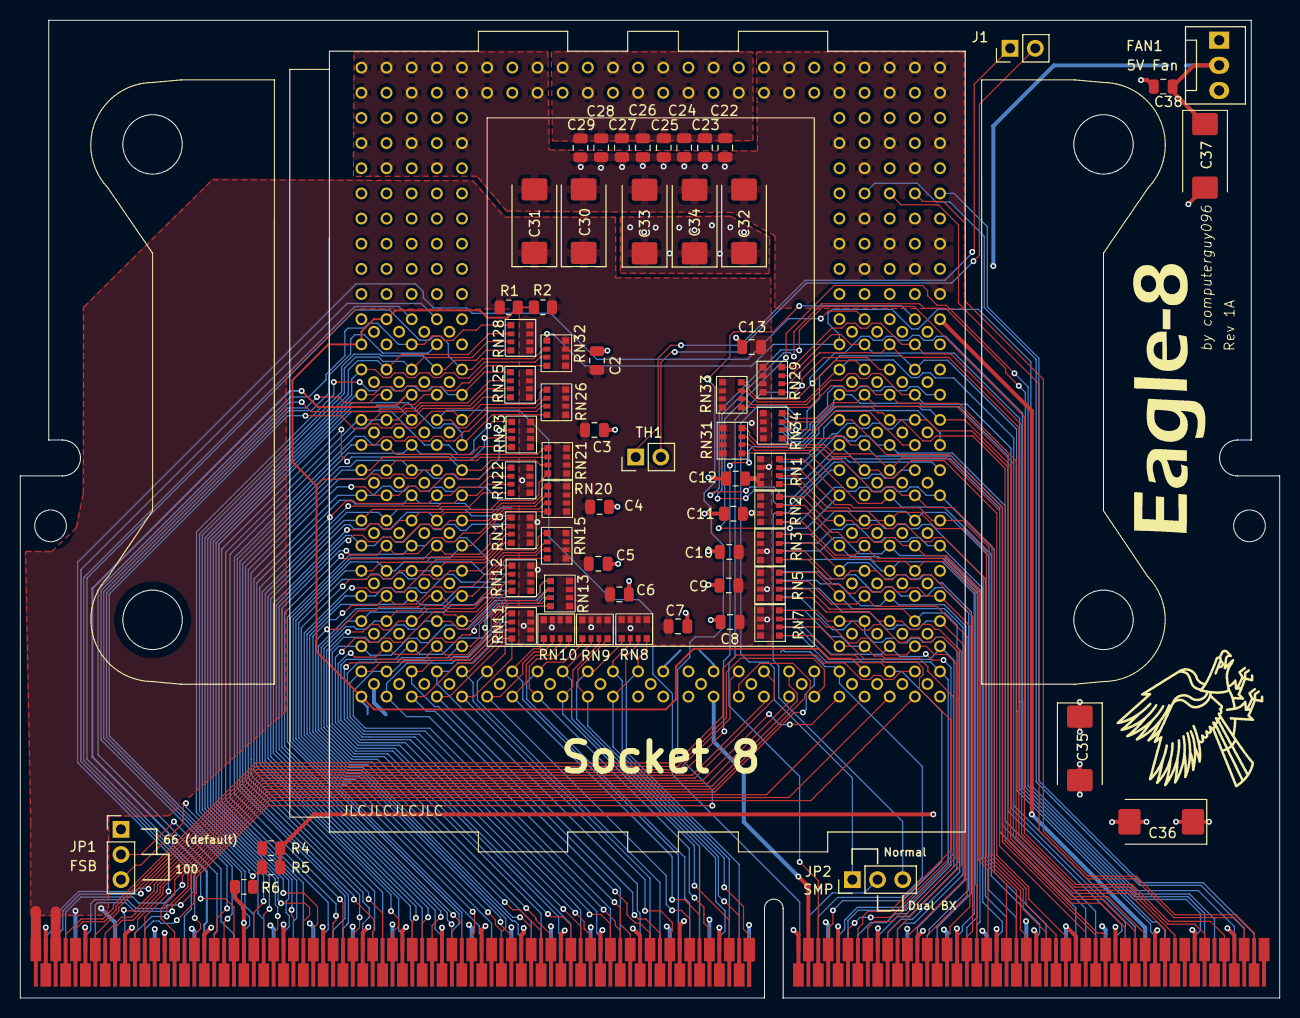
[picture p4: board eagle-8.kicad_pcb from above]

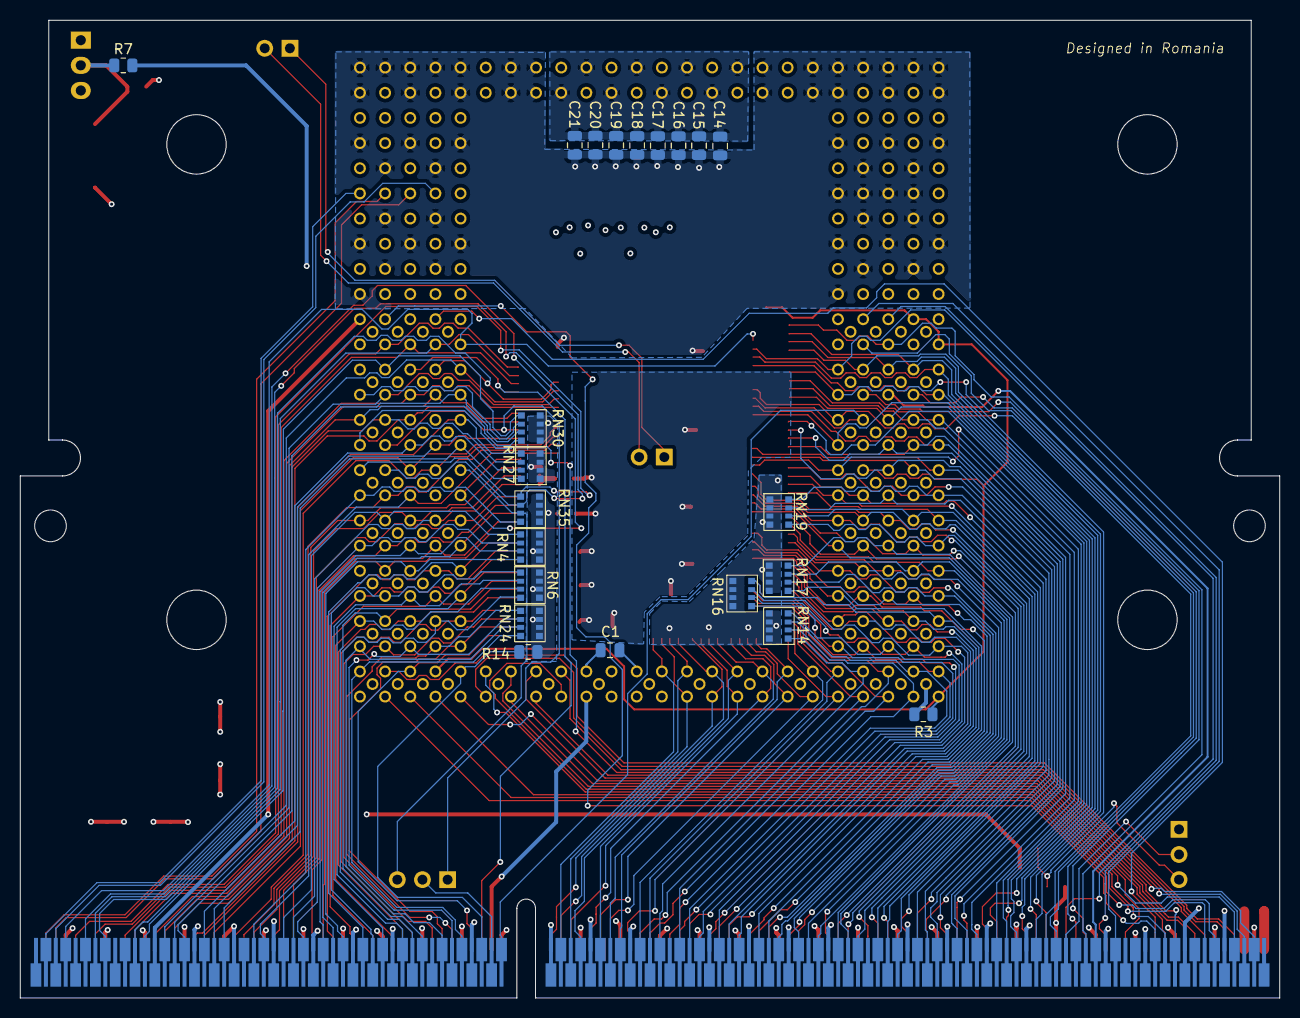
[picture p5: board eagle-8.kicad_pcb from below]

Board: 4 copper layers, 127.1 x 98.7 mm, 91 parts (22 on the bottom side), 181 nets.
