computerguy096/Eagle-8/(commit log)

2026-09-04 fixed s8 footprint, important routing
    [eagle-8.kicad_pcb, eagle-8.kicad_sch]
2026-09-07 finished routing, added AM3 mounting holes
    [eagle-8.kicad_pcb, eagle-8.kicad_sch]
2026-10-21 more improvements
    [eagle-8.kicad_pcb, eagle-8.kicad_sch]
2026-10-21 removed most of the inner layer traces
    [eagle-8.kicad_pcb, eagle-8.kicad_sch]
2026-10-22 finalized routing
    [eagle-8.kicad_pcb, eagle-8.kicad_sch]
2026-10-31 added FSB jumper, fan, AM3 spacers
    [eagle-8.kicad_pcb, eagle-8.kicad_sch, spacer.stl]
2026-10-31 prepared for PCBA
    [eagle-8.csv, eagle-8.kicad_sch]
2026-11-01 update to kicad 10
    [eagle-8.kicad_pcb, eagle-8.kicad_sch]
2026-11-03 added BR1-3 jumper
    [eagle-8-B_Mask.gbr, eagle-8-B_Paste.gbr, eagle-8-B_Silkscreen.gbr, eagle-8-Back.gbr, eagle-8-Edge_Cuts.gbr, eagle-8-F_Mask.gbr, eagle-8-F_Paste.gbr, eagle-8-F_Silkscreen.gbr]
2026-11-05 fixed BOM
    [eagle-8.csv, eagle-8.kicad_pcb, eagle-8.kicad_sch]
